ogonek-spider/physical-structure/CHANGELOG.md

# Changelog

## [Unreleased]

- Renamed `model/` folder to `cad/`.
- Added `OldVersions/` to `.gitignore` (matches all nested `OldVersions` folders).
