ogonek-spider/physical-structure/robot_memory_context_for_codex.md

# Контекст проекта шестиногого робота для Codex

**Владелец проекта:** Tony Larin  
**Назначение файла:** исходный контекст для проектирования редуктора/коробки и суставов робота в Codex.  
**Дата выгрузки:** 2026-05-24  
**Приоритет данных:** сведения в разделе «Актуальные исходные данные» имеют приоритет над более ранними обсуждениями и историческими допущениями.

---

## 1. Актуальные исходные данные — использовать как источник истины

### Проект
- Проект: крупный шестиногий робот / hexapod.
- Количество ног: 6.
- Кинематика: 3 DOF на ногу, всего **18 приводных суставов**.
- Целевой масштаб обсуждался как робот высотой около **2 м**.
- Целевая/расчётная общая масса робота: около **100 кг**.
- Для одного из расчётов опоры использовалось допущение, что вес распределён на **5 ног**.
- Зафиксированная геометрия для расчёта бедренного сустава: горизонтальное расстояние от сустава femur до стопы **0,641 м**.

### Мотор — критически важно
- Используемый/планируемый мотор: мотор от гироскутера / hoverboard hub motor.
- **Актуально сохранённый крутящий момент мотора: 4 Н·м.**
- Все старые расчёты с **7 Н·м** считать устаревшими и не использовать без явного пересчёта.
- Мотор был/может быть механически модифицирован: обсуждалась замена стального магнитопровода/части ротора на пластик, из-за чего момент может быть ниже штатного.
- Актуальный печатный ротор мотора: **PLA**, **100% заполнение**, печать под **45°**.
- **PETG для ротора не подходит**: не хватает жёсткости.

### Текущий редуктор и направление разработки
- В проекте уже обсуждался/использовался двухступенчатый планетарный редуктор **1:36**.
- Также проводились тесты/обсуждения промежуточного редуктора **1:6**.
- Текущий интерес: спроектировать новую коробку/редуктор, потому что **1:36 может быть недостаточно** для целевого робота.
- Пользователь рассматривал повышение передаточного отношения примерно до **1:64** и выше.
- Предпочтение: собственная/изготавливаемая конструкция редуктора вместо дорогих готовых интегрированных актуаторов.

### Материалы и изготовление
- Робот/детали конструкции планировались с большим использованием **3D-печати PETG**.
- Для шестерён рассматривались **PA6-CF** и обычный **PA6**.
- Для солнечной шестерни также рассматривался алюминий **Д16Т**.
- Для звеньев ног рассматривался алюминиевый профиль, в частности порядка **40×60 мм**.
- Для суставов рассматривались алюминиевые C-bracket/вилки с двумя разнесёнными подшипниками.
- Важное конструктивное предпочтение: изгибающую нагрузку сустава должны воспринимать подшипники/корпус, а не зубья планетарного редуктора.

---

## 2. Геометрия ног и конструкция робота

### Известные требования и обсуждавшиеся варианты
- Нога имеет три основных звена/сустава: coxa, femur, tibia.
- Пользователь изучал, зачем нужна coxa и можно ли крепить бедренный сустав напрямую к корпусу.
- Обсуждалась геометрия крупного робота с коленом/бедром, работающим при значительных плечах и статических моментах.
- Для робота высотой около 2 м ранее как ориентир обсуждались:
  - coxa около **0,35 м**;
  - femur около **0,65–0,75 м**;
  - tibia около **1,4–1,6 м**.
- Эти размеры являются ранними ориентирами, а не утверждённой финальной геометрией.
- Обсуждалась идея треугольных/ферменных звеньев ног и размещения приводов ближе к корпусу для снижения неподрессоренной/маховой массы.

### Масштабирование
- Для крупного робота важен эффект square–cube law: масса растёт быстрее несущей способности при простом увеличении геометрии.
- Из этого следует необходимость значительного запаса по моменту, жёсткости, подшипникам и ударным нагрузкам.

---

## 3. Нагрузки и зафиксированные расчётные сценарии

### Тестовый сценарий сустава
- Зафиксирован тест: груз **5 кг** на плече **0,5 м**.
- Требуемый статический момент в этом тесте:
  - `5 × 9.81 × 0.5 ≈ 24.5 Н·м`.

### Сценарий массы робота на 5 ногах
- Общая масса: **100 кг**.
- Количество опор в сценарии: **5 ног**.
- Горизонтальное плечо femur-to-foot: **0,641 м**.
- Нагрузка на одну ногу: `100 × 9.81 / 5 ≈ 196.2 Н`.
- Статический момент на femur одной ноги:
  - `196.2 × 0.641 ≈ 125.8 Н·м`.

### Сценарий опоры на 3 ногах / tripod gait
- При распределении веса на 3 ноги:
  - сила на одну ногу `100 × 9.81 / 3 ≈ 327 Н`;
  - статический момент при плече 0,641 м: `≈ 209.6 Н·м`.
- Это полезный более тяжёлый сценарий для проектирования, если робот должен ходить tripod gait.

### Следствие для передаточного отношения с актуальным мотором 4 Н·м
Ниже приведены ориентиры, а не утверждённая спецификация. Для окончательного проекта нужно выбрать КПД, динамический коэффициент, режим походки и допустимый ток мотора.

| Сценарий | Момент на суставе | Идеальное отношение при 4 Н·м, без потерь |
|---|---:|---:|
| Тест 5 кг × 0,5 м | 24,5 Н·м | 6,1:1 |
| 100 кг, опора на 5 ног, плечо 0,641 м | 125,8 Н·м | 31,5:1 |
| 100 кг, опора на 3 ноги, плечо 0,641 м | 209,6 Н·м | 52,4:1 |

- При учёте потерь и запаса передаточное отношение должно быть больше идеального.
- Для ориентира: при КПД `0,8` и запасе `2×`:
  - сценарий 5 ног требует примерно `78,6:1`;
  - сценарий 3 ног требует примерно `131:1`.
- Поэтому старый редуктор **1:36** может удерживать только ограниченные статические режимы и не выглядит достаточным для полноразмерной ходьбы с хорошим запасом.

---

## 4. Планетарный редуктор: предыдущие решения и вопросы

### Текущая/предыдущая архитектура
- Двухступенчатая планетарная передача **1:36**.
- Рассматривалось перемещение планетарного редуктора внутрь C-bracket сустава, как в роботизированных приводах.
- Изучался вариант split-ring planetary; ранее предпочтение было сохранить обычную планетарную схему, если split-ring не нужен ради упаковки или особой компоновки.

### Ранее обсуждавшиеся конструктивные рекомендации
- Финальная ступень должна быть максимально прочной; обсуждалась стальная финальная ступень.
- Нужны крупные выходные подшипники.
- Нужен жёсткий водило/carrier.
- Нужна защита от ударных нагрузок.
- Нужно минимизировать люфт.
- Нельзя передавать изгибающую нагрузку ноги через зубчатое зацепление; выход сустава должен поддерживаться отдельными подшипниками.

### Солнечная шестерня и размеры, обсуждавшиеся ранее
Для раннего сценария входного момента **7 Н·м** обсуждались ориентиры для PA6-CF солнечной шестерни:
- делительный диаметр солнца около **24–32 мм**;
- число зубьев **12–16**;
- модуль около **2,0–2,5**;
- ширина венца около **12–18 мм**.

**Важно:** эти размеры обсуждались при старом входном моменте 7 Н·м. Перед использованием в новом проекте пересчитать под актуальные **4 Н·м**, требуемый ресурс, ударную нагрузку, материал, температуру, люфт и технологию печати/обработки.

### Ранее обсуждавшаяся пластиковая деталь/ротор
- Обсуждался пластиковый ротор/диск диаметром около **50 мм**, соединённый с планетарной частью.
- Один из вариантов использовал нагретые резьбовые вставки M3 и **4 болта M3**.
- Возникал вопрос, сможет ли это соединение передать момент на входе планетарного редуктора.
- Для другой печатной составной детали описывались:
  - диск A: наружный диаметр **50 мм**, толщина **7,5 мм**, внутри посадка под подшипник;
  - диск B: наружный диаметр **92 мм**, толщина **5 мм**, с элементами водила планет;
  - **4 закладные гайки M6** по квадрату **20 мм**;
  - проблема: гайки вырывались/диски разрывались между собой.
- Обсуждались решения с алюминиевой вставкой, фланцевой ступицей/бобышкой и штифтами для передачи момента и сопротивления расслоению.

---

## 5. Сустав, подшипники и C-bracket

- Пользователь рассматривает C-образный кронштейн/вилку из листового алюминия для суставов.
- Планируется опора оси сустава на **два разнесённых подшипника**.
- Обсуждалась компоновка, при которой редуктор встроен внутрь кронштейна.
- Критическая задача: правильно вывести и зафиксировать выход редуктора в C-bracket, чтобы:
  - радиальные и изгибающие нагрузки принимали подшипники;
  - зубья и водило преимущественно передавали крутящий момент;
  - люфт не приводил к раскачке длинной ноги.

---

## 6. Приводы, ODrive и датчики

### Контроллер
- Используется/имеется **MKS ODrive Mini V1.0**.
- Это Makerbase/legacy ODrive-совместимая плата, а не современный ODrive S1/Pro.
- На плате имеются отдельные подключения **ABZ/HALL** и **SPI**.
- Это позволяет одновременно подключить:
  - Hall-датчики мотора для коммутации/FOC;
  - абсолютный энкодер после редуктора для измерения угла сустава.

### Предпочтительная архитектура управления, обсуждавшаяся ранее
- Hall-датчики использовать для коммутации мотора/FOC.
- Абсолютный энкодер после коробки использовать как истинный датчик позиции сустава.
- Контур положения/момента потенциально реализовать локально на MKS ODrive или внешнем контроллере.
- ROS должен передавать желаемые позиции суставов по CAN.
- Пользователь рассматривал возможность модифицировать прошивку ODrive для поддержки такой схемы.
- Также рассматривался ESP32 для считывания абсолютного энкодера; пользователь спрашивал, можно ли отказаться от него и работать через ROS USB-CAN/модификацию прошивки.

### Настройка и измерения ODrive
- В тестах использовался hoverboard motor и ODrive.
- Hall wiring и `pos_estimate` работали.
- Мотор мог вращаться во время калибровки/старта; для безопасных тестов автодвижение при запуске нужно отключать.
- Пользователь решал проблему, когда мотор не стартовал при `input_vel = 1`, но запускался с толчка/на более высокой скорости.
- В одном из тестов:
  - `motor.config.torque_constant` был установлен в `1.0`, что было признано сомнительным/неверным стартовым значением;
  - обсуждалась стартовая оценка `torque_constant ≈ 0.52 Н·м/А`, но она не считается подтверждённой измерением;
  - `motor.config.current_lim = 10.0 A`.
- Для проверки тока использовались/обсуждались:
  - `Iq_setpoint`;
  - `Iq_measured` — q-ток, формирующий момент;
  - `Id_measured` — должен быть близок к нулю;
  - батарейный ток не равен фазному току мотора.
- Обсуждавшиеся стартовые пределы/настройки мотора:
  - motor phase current soft max около **10 A**;
  - hard max около **15 A**;
  - calibration current около **4 A**;
  - resistance calibration max voltage около **4 V**;
  - для типичного мотор-колеса использовалось предположение **15 pole pairs**;
  - для Hall-датчиков обсуждалось `cpr = 90`.

### Питание
- Обсуждался выбор между батареями **36 В** и **48 В**.
- Пользователь задавался вопросом питания 18 моторов, особенно при одновременном удержании нагрузки.
- Обсуждались батареи гироскутера, аккумулятор Xiaomi Mijia M365 и параллельное подключение батарей.
- Итоговая электрическая архитектура питания не зафиксирована.

---

## 7. Ограничения стоимости и предпочтения пользователя

- Готовый интегрированный привод оценивался примерно в **$583 за один сустав**.
- При 18 суставах это даёт около **$10 494**, что для проекта неприемлемо дорого.
- Поэтому предпочтительное направление:
  - моторы от гироскутера;
  - собственные редукторы;
  - собственная механика сустава;
  - доступные контроллеры ODrive/MKS;
  - по возможности печатные или самостоятельно обрабатываемые детали.

---

## 8. Что уже считается проблемой / зоной риска

1. **Момент мотора был переоценён:** старое значение 7 Н·м заменено на актуальное 4 Н·м.
2. **Передаточное отношение 1:36 вероятно мало** для 100-килограммового робота с длинными ногами, особенно в tripod gait и с динамическим запасом.
3. **Печатные детали передачи момента** с маленькими вставками/болтами уже вызывали проблемы вырывания и разделения деталей.
4. **Нужна независимая опора выхода сустава**: редуктор не должен воспринимать изгибающие нагрузки ноги.
5. **Hall-сенсоров недостаточно для хорошего положения сустава после редуктора**: нужен выходной абсолютный энкодер из-за люфта, упругости и неизвестного истинного угла ноги.
6. **Пиковый и удерживающий ток 18 моторов** — ключевая системная проблема по батарее, проводке, контроллерам и охлаждению.
7. **Модифицированный магнитный путь мотора** может снизить фактический момент; момент необходимо подтвердить испытанием.
8. **Материал ротора**: ротор печатать из PLA со 100% заполнением и ориентацией 45°; PETG для ротора недостаточно жёсткий.

---

## 9. Данные, которые ещё нужно определить перед финальным проектом коробки

Codex не должен придумывать эти параметры; их надо запросить у владельца проекта или оставить переменными:

- Конкретный сустав, для которого сейчас проектируется коробка: coxa, femur или tibia.
- Требуемый режим: стояние, медленная ходьба, tripod gait, ударная нагрузка/ступенька.
- Итоговые размеры звеньев и рабочее плечо для каждого сустава.
- Подтверждённая моментная характеристика мотора:
  - момент при заданном `Iq_measured`;
  - допустимый длительный ток;
  - допустимый пиковый ток;
  - нагрев.
- Целевое передаточное отношение и допустимая скорость сустава.
- Допустимый люфт и требуемый ресурс.
- Материал каждой ступени: печатный PA6/PA6-CF, Д16Т, сталь или комбинация.
- Размеры доступных подшипников, оси и габариты C-bracket.
- Итоговое питание: напряжение аккумулятора и допустимая мощность/ток на 18 суставов.

---

## 10. Правила для Codex при работе с этим проектом

1. Всегда использовать **4 Н·м** как актуальный номинальный момент мотора, пока пользователь не предоставит новое измерение.
2. Не использовать старые расчёты, сделанные при 7 Н·м, без явного пересчёта.
3. Для расчёта бедренного сустава учитывать известное плечо **0,641 м** и массу робота **100 кг**, если пользователь не задаст новые параметры.
4. Разделять:
   - статическое удержание;
   - динамическую ходьбу;
   - ударные нагрузки;
   - тепловые ограничения при длительном удержании.
5. Не проектировать зубчатую передачу как единственную опору ноги: выходной вал должен иметь отдельную пару разнесённых подшипников.
6. При проектировании печатных передач отдельно проверять:
   - напряжения в зубьях;
   - смятие отверстий/вставок;
   - срез болтов и штифтов;
   - разрыв слоёв печати;
   - ползучесть пластика;
   - нагрев;
   - ударную нагрузку.
7. Для замкнутого управления суставом предусматривать абсолютный энкодер после редуктора.
8. Все новые инженерные решения маркировать как предложение, а не как уже принятое решение владельца.

---

## 11. Короткий prompt для начала работы в Codex

```text
Я проектирую редуктор сустава для крупного шестиногого робота. Используй файл robot_memory_context_for_codex.md как источник контекста. Критически важно: актуальный момент hoverboard-мотора равен 4 Н·м; старые упоминания 7 Н·м устарели. Робот примерно 100 кг, 18 суставов, для femur известное горизонтальное плечо до стопы 0,641 м. Сначала выдели переменные и неподтверждённые параметры, затем помоги спроектировать редуктор с отдельной подшипниковой опорой выхода, не передавая изгибающую нагрузку через зубчатое зацепление.
```

---

## 12. История исходных воспоминаний и оговорки

- Ранние обсуждения 2026-03 и 2026-04 содержали оценку мотора **7 Н·м** и двухступенчатого редуктора **1:36**.
- 2026-05-23 пользователь явно попросил считать момент мотора **4 Н·м, а не 7 Н·м**; это значение имеет высший приоритет.
- Многие размеры редуктора и ноги были предметом исследования, а не окончательной спецификацией.
- Этот документ является выгрузкой контекста проекта, а не готовым инженерным расчётом или финальной КД.
