ogonek-spider/physical-structure/planetary_gearbox/gearbox_1_81.md

# Двухступенчатая планетарная коробка 1:81

Статус: выбранный рабочий кандидат для проектирования CAD.  
Дата: 2026-05-24.  
Назначение: редуктор для крупных суставов hexapod, прежде всего femur, где текущая 1:36 коробка не даёт достаточный момент.

## Исходные данные

- Мотор: hoverboard hub motor.
- Ротор мотора: PLA, 100% заполнение, печать под 45°.
- PETG для ротора не использовать: не хватает жёсткости.
- Измеренная константа момента: `Kt = 0.22 Нм/А`.
- Безопасный длительный фазный ток: `15 А`.
- Ток `25 А` не использовать: плавит PLA-ротор.
- Расчётный момент мотора при 15 А: `0.22 × 15 = 3.3 Нм`.
- КПД одной планетарной ступени для расчётов: `0.9`.
- КПД двух ступеней: `0.81`.
- Расчётный выходной момент при 1:81: `3.3 × 81 × 0.81 = 216.5 Нм`.
- Требуемый момент femur из текущего расчёта: около `137 Нм`.
- Расчётный запас по моменту для femur: `216.5 / 137 = 1.58×`.

## Выбранная архитектура

- Тип: двухступенчатая простая планетарная передача.
- Общее передаточное отношение: `1:81`.
- Передаточное отношение каждой ступени: `9:1`.
- Число ступеней: `2`.
- Число планет на ступень: `3`.
- Зубья: прямые, без helix.
- Угол наклона зубьев: `0°`.
- Причина отказа от helix: алюминиевое/металлическое солнце с косым зубом сложно изготовить на доступном оборудовании.

## Геометрия одной ступени

| Деталь | Зубья | Материал, текущий выбор |
|---|---:|---|
| Sun | 12 | металл, предпочтительно сталь; Д16Т допустим для прототипа |
| Planet | 42 | PA6-CF |
| Ring | 96 | PA6-CF в жёстком корпусе/бандаже |

Проверки:

```text
Ring = Sun + 2 × Planet
96 = 12 + 2 × 42 ✓

i_stage = 1 + Ring / Sun
i_stage = 1 + 96 / 12 = 9 ✓

i_total = 9 × 9 = 81 ✓

Условие равномерной сборки 3 планет:
(Sun + Ring) / 3 = целое
(12 + 96) / 3 = 36 ✓
```

## Модуль и размеры

- Модуль: `m = 2 мм`.
- Pressure angle: предварительно `25°`.
- Причина выбора `25°`: уменьшить риск undercut и усилить малое солнце.
- Profile shift: для `Sun 12T` при `PA25` уже не так критичен, как для `9T`; положительный shift можно использовать как улучшение, но он не должен быть обязательным условием генерации.

Делительные диаметры:

```text
Sun:    12 × 2 = 24 мм
Planet: 42 × 2 = 84 мм
Ring:   96 × 2 = 192 мм
```

Ориентировочный наружный диаметр кольцевой шестерни с корпусом: `205-220 мм`, зависит от толщины стенки, крепежа и бандажа.

## Высота зубчатых венцов

Ограничение: высота используемого подшипника `8 мм`, поэтому высота шестерни должна быть кратна `8 мм`.

Выбранный вариант:

| Ступень | Высота венца |
|---|---:|
| Stage 1 | 16 мм |
| Stage 2 | 24 мм |

Более простой производственный вариант:

```text
Stage 1: 24 мм
Stage 2: 24 мм
```

Минимальный допустимый вариант:

```text
Stage 1: 16 мм
Stage 2: 24 мм
```

Не рекомендуется:

```text
8 мм на любой силовой ступени
```

## Нагрузки на вторую ступень

При `15 А`:

```text
T_motor = 0.22 × 15 = 3.3 Нм
T_sun_stage_2 ≈ 3.3 × 9 × 0.9 = 26.7 Нм
r_sun = 24 / 2 = 12 мм
Ft_total ≈ 26.7 / 0.012 = 2225 Н
Ft_per_planet ≈ 2225 / 3 = 742 Н
```

Это мягче для солнца второй ступени, чем вариант `1:100, m=3, Sun=9T`, и заметно проще для генератора шестерён, потому что `Sun 12T` при `PA25` не требует агрессивного profile shift.

Сравнение с существующей `1:36` коробкой:

```text
1:36 stage 2 sun torque:
3.3 × 6 × 0.9 = 17.8 Нм

1:81 stage 2 sun torque:
3.3 × 9 × 0.9 = 26.7 Нм
```

Нагрузка второй ступени примерно в `1.5×` выше, чем у существующей `1:36`. Поэтому `Stage 2` должен быть шире:

```text
1:36: 17.8 Нм / 16 мм = 1.11 Нм/мм
1:81: 26.7 Нм / 24 мм = 1.11 Нм/мм
```

Это сохраняет похожую нагрузку на миллиметр ширины зубчатого венца, но не отменяет проверки износа и ударных нагрузок.

## Материалы

Текущий рекомендуемый набор:

| Деталь | Stage 1 | Stage 2 |
|---|---|---|
| Sun | металл | металл, желательно |
| Planets | PA6-CF | PA6-CF, держать запасные |
| Ring | PA6-CF | PA6-CF с жёстким наружным корпусом |
| Carrier | металл или усиленный композит | металл предпочтительно |
| Shafts/pins | сталь | сталь |

Примечания:

- PA6-CF требует смазки.
- Текущая смазка из проекта: MC Rubin EP2.
- PETG не должен быть основной силовой деталью зубчатого зацепления.
- PETG не использовать для ротора мотора: не хватает жёсткости. Текущий ротор: PLA, 100% заполнение, печать под 45°.
- Изгибающая нагрузка ноги не должна проходить через зубчатую передачу.

## Подшипники и опора выхода

Принципиально:

- Редуктор передаёт крутящий момент.
- Радиальные и изгибающие нагрузки сустава должны воспринимать отдельные разнесённые подшипники C-bracket/сустава.
- Выходной вал/фланец редуктора не должен быть единственной опорой ноги.
- Энкодер желательно ставить на реальную выходную ось сустава после редуктора.

Связанное текущее решение из `limbs.md`:

- Joint frame: PETG.
- Два подшипника `61910`.
- Расстояние между подшипниками: `100 мм`.
- Толщина frame: `10 мм`.
- Нога крепится к выходному фланцу через `4×M6 8.8`.

## Риски

1. `1:81` даёт меньше момента, чем `1:100`, но запас для femur остаётся около `1.58×`.
2. `m=2` компактнее, но зубья работают тяжелее, чем при `m=2.5`; `Stage 2 = 24 мм` считать обязательным.
3. PA6-CF ring второй ступени нуждается в жёстком наружном удержании, иначе возможна овальность и рост люфта.
4. Люфт двухступенчатой планетарки может быть заметен на длинной ноге, поэтому нужен выходной абсолютный энкодер.
5. При 1:81 скорость сустава будет ниже, чем у 1:36 и 1:64; надо проверить, хватает ли скорости для походки.
6. Если sun stage 2 сделать из Д16Т, надо проверить износ по PA6-CF планетам со смазкой.

## Недостающие параметры, которые нужно подтвердить

Перед CAD:

- Для какого сустава эта коробка финально делается: femur, tibia или универсальная femur/tibia.
- Максимальный допустимый наружный диаметр редуктора.
- Максимальная допустимая общая толщина редуктора.
- Доступный диаметр и длина моторного вала/посадки солнца первой ступени.
- Как именно sun stage 1 крепится к мотору.
- Как stage 1 carrier передаёт момент на sun stage 2.
- Диаметр осей планет.
- Тип и размер подшипников планет.
- Радиальный зазор и backlash, допустимые для печати/CNC.
- Точный gear generator/CAD workflow: умеет ли он `25° PA`.
- Материал металлического солнца: сталь или Д16Т.
- Будет ли ring цельнопечатный, сегментированный или вставлен в металлический корпус.
- Способ фиксации ring от проворота в корпусе.
- Требуемая максимальная скорость сустава на выходе.
- Допустимый люфт на выходе в градусах.
- Нужен ли единый редуктор для всех 18 суставов или разные версии для coxa/femur/tibia.

Перед изготовлением:

- Проверить фактический backlash на напечатанных PA6-CF планетах.
- Проверить посадки после влагонасыщения/сушки PA6-CF.
- Сделать тест на 15 А длительно с контролем температуры мотора, редуктора и PLA-ротора.
- Сделать стендовый тест `137 Нм` удержания и циклический тест ходьбы.
- Отдельно проверить износ металлического солнца по PA6-CF планетам со смазкой.

## Текущий вывод

`m=2`, spur, `12/42/96`, две ступени `9:1 + 9:1` — выбранный кандидат для редуктора `1:81`.

По сравнению с `1:100` он даёт меньше момента, но сохраняет нормальный запас для femur и уходит от проблемного маленького `9T` солнца с обязательным profile shift. По сравнению с `m=2.5` корпус получается существенно компактнее, но вторая ступень должна быть шириной `24 мм`.
