ogonek-spider/physical-structure/planetary_gearbox/gearbox_1_36.md

# Существующая планетарная коробка 1:36

Статус: существующая проверенная конструкция.  
Дата фиксации: 2026-05-24.  
Назначение: базовая двухступенчатая коробка hoverboard motor; полезна для tibia/coxa и как сравнение для новых редукторов.

## Исходные данные

- Мотор: hoverboard hub motor.
- Ротор мотора: PLA, 100% заполнение, печать под 45°.
- PETG для ротора не использовать: не хватает жёсткости.
- Измеренная константа момента: `Kt = 0.22 Нм/А`.
- Безопасный длительный фазный ток: `15 А`.
- Ток `25 А` не использовать: плавит PLA-ротор.
- Расчётный момент мотора при 15 А: `0.22 × 15 = 3.3 Нм`.
- КПД одной планетарной ступени для расчётов: `0.9`.
- КПД двух ступеней: `0.81`.

## Архитектура

- Тип: двухступенчатая простая планетарная передача.
- Передаточное отношение каждой ступени: `6:1`.
- Общее передаточное отношение: `6 × 6 = 36`.
- Модуль: `m = 2 мм`.
- Число планет: `3`.
- Зубья: helical `15°`.
- Высота/ширина зубчатого венца: `16 мм`.
- Материал шестерён: PA6-CF.
- Смазка: MC Rubin EP2.

Конструктивная деталь текущей 1:36 коробки:

- Выход первой ступени сделан одной деталью вместе с sun gear второй ступени.
- Эта деталь напечатана из PLA.
- Заполнение: `100%`.
- Ориентация печати: `45°`.

## Геометрия одной ступени

| Деталь | Зубья |
|---|---:|
| Sun | 12 |
| Planet | 24 |
| Ring | 60 |

Проверки:

```text
Ring = Sun + 2 × Planet
60 = 12 + 2 × 24 ✓

i_stage = 1 + Ring / Sun
i_stage = 1 + 60 / 12 = 6 ✓

i_total = 6 × 6 = 36 ✓
```

## Измеренный момент

| Режим | Phase current | Output torque |
|---|---:|---:|
| Holding / stall | 15 А | 98 Нм |
| Lifting / dynamic | 25 А | >= 98 Нм |

Важно:

- `15 А` — текущий безопасный тепловой предел.
- `25 А` плавит PLA-ротор, не использовать как рабочий режим.
- Из измерения `98 Нм @ 15 А` получена константа `Kt = 0.22 Нм/А`.

Расчётная формула из измерения:

```text
T_out = N × 0.22 × I × 0.81
```

Для `1:36` при `15 А`:

```text
T_out = 36 × 0.22 × 15 × 0.81 = 96.2 Нм
```

Это совпадает с измеренными `98 Нм` достаточно близко для проектного расчёта.

## Сравнение с текущими требованиями ноги

| Сустав | Требуемый момент | Доступно с 1:36 @ 15 А | Запас |
|---|---:|---:|---:|
| Femur | 137 Нм | 98 Нм | 0.71× FAIL |
| Tibia | 82 Нм | 98 Нм | 1.20× |
| Coxa | около 15 Нм | 98 Нм | большой |

## Вывод

- Для femur текущая `1:36` коробка недостаточна при безопасном токе `15 А`.
- Для tibia она может работать с небольшим запасом.
- Для coxa она избыточна по моменту.
- `1:36` полезна как проверенная базовая конструкция, но не как финальный femur-редуктор для текущей массы и геометрии.
