ogonek-spider/physical-structure/(list of files, cad)

Other CAD files:
cad/_Full_Ass_.iam
cad/body_frame.iam
cad/body_parts/bearing_mass.ipt
cad/body_parts/body_composition.ipt
cad/body_parts/ground.ipt
cad/body_parts/motor_mass.ipt
cad/leg_Left_ass.iam
cad/leg_Right_ass.iam
cad/leg_coxa/coxa_support_steel.ipt
cad/leg_coxa/coxa_upper_steel.ipt
cad/leg_coxa/femur_motor_steel.ipt
cad/leg_coxa/femur_outside_steel.ipt
cad/leg_coxa/leg_Left_coxa_ass.iam
cad/leg_coxa/shaft_coxa.ipt
cad/leg_femur/femur_motor_steel.ipt
cad/leg_femur/femur_outside_steel.ipt
cad/leg_femur/femur_profile.ipt
cad/leg_femur/femur_support_steel.ipt
cad/leg_femur/leg_Left_femur_ass.iam
cad/leg_femur/leg_Right_femur_ass.iam
cad/leg_femur/shaft_femur.ipt
cad/leg_tibea/leg_Left_tibea_ass.iam
cad/leg_tibea/leg_Right_tibea_ass.iam
cad/leg_tibea/shaft_tibea.ipt
cad/leg_tibea/tibea_inside_steel.ipt
cad/leg_tibea/tibea_outside_steel.ipt
cad/leg_tibea/tibea_profile.ipt
cad/leg_tibea/tibea_vodilo_steel.ipt
cad/steel_template.ipt
