ogonek-spider/physical-structure/(commit log)

2026-04-07 mass calculations, final limbs length
    [bearing__configuration_b6013.stl, femur__limb_legnth_0_3_meter.stl, femur__limb_legnth_0_4_meter.stl, limbs.stl, motor_holder.stl, motor_model.stl, moving_frame_l.stl, moving_frame_r.stl]
2026-04-28 Add CAD model, CHANGELOG, ignore OldVersions
    Move existing Inventor project files under cad/ (assemblies, parts,
    FEA results, parametres.xlsx). Add CHANGELOG.md per global rule.
    Ignore OldVersions/ folders at any depth.
    [_Full_Ass_.iam, bearing_mass.ipt, body_composition.ipt, body_frame.iam, coxa_support_steel.ipt, coxa_upper_steel.ipt, femur_motor_steel.ipt, femur_outside_steel.ipt]
2026-05-24 update with measured motor torque
